FilipKosel/ODORS/End_Cap_3D_Models/End_Cap-5mm_Hole-Slotted_Edge_for_VOC_Meter.stl

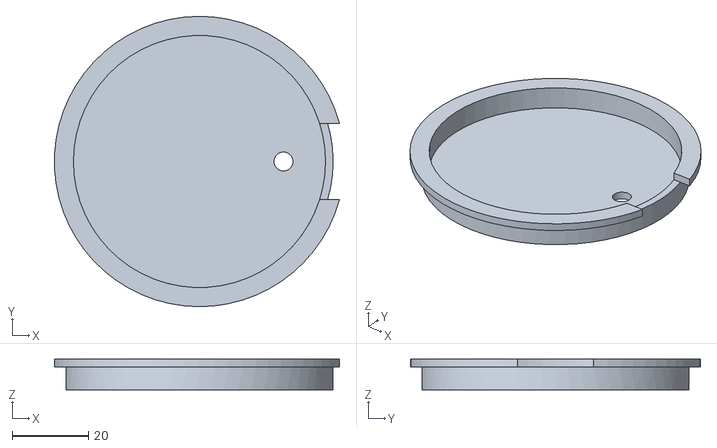
[picture p1: CAD file, 2025-01-09]
End_Cap_3D_Models/End_Cap-5mm_Hole-Slotted_Edge_for_VOC_Meter.stl
74.6 x 76.0 x 8.00
