FilipKosel/ODORS/End_Cap_3D_Models/End_Cap-Short_Odour_Tube-Solid_Edge_w_Centering_Tab-Low_Offset.stl

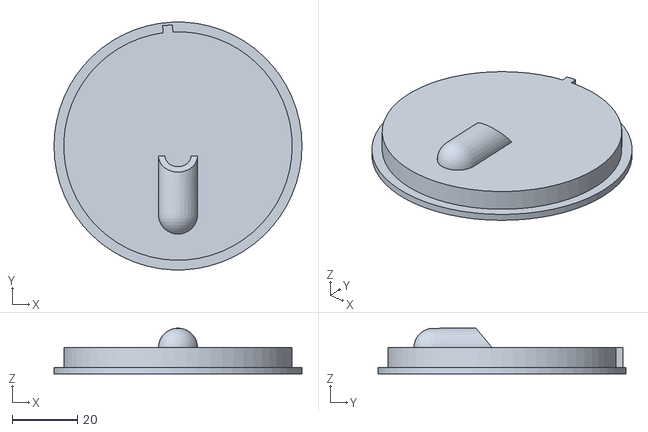
[picture p2: CAD file, 2025-01-09]
End_Cap_3D_Models/End_Cap-Short_Odour_Tube-Solid_Edge_w_Centering_Tab-Low_Offset.stl
76.0 x 75.9 x 14.0
