FilipKosel/ODORS/End_Cap_3D_Models/End_Cap-8mm_Hole-Solid_Edge.stl

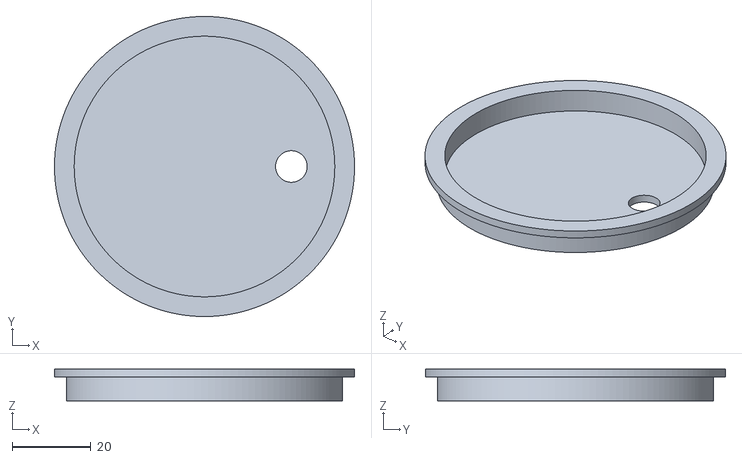
[picture p3: CAD file, 2025-01-09]
End_Cap_3D_Models/End_Cap-8mm_Hole-Solid_Edge.stl
76.0 x 76.0 x 8.00
