FilipKosel/ODORS/End_Cap_3D_Models/End_Cap-Short_Odour_Tube-Slotted_Edge_for_VOC_Meter.stl

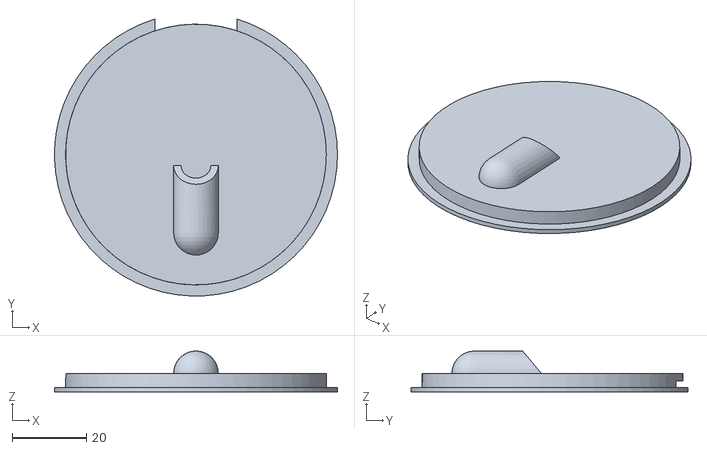
[picture p4: CAD file, 2025-01-09]
End_Cap_3D_Models/End_Cap-Short_Odour_Tube-Slotted_Edge_for_VOC_Meter.stl
76.0 x 74.3 x 11.0
