FilipKosel/ODORS/End_Cap_3D_Models/End_Cap-Long_Odour_Tube-Solid_Edge.stl

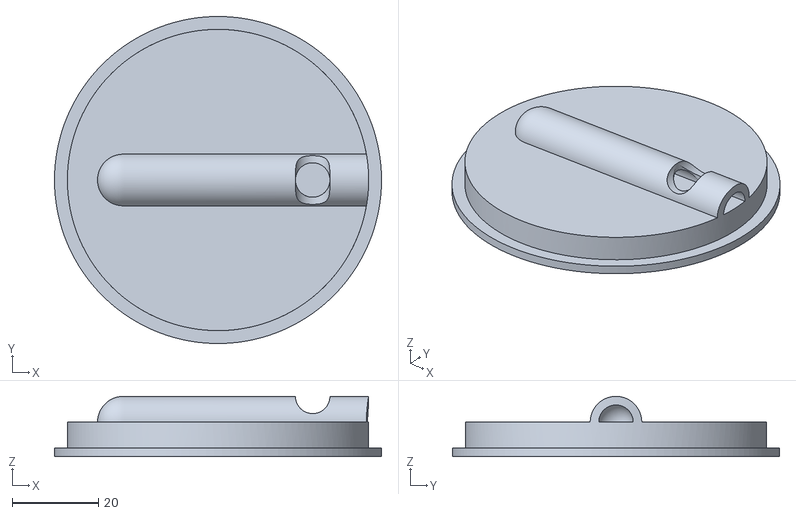
[picture p5: CAD file, 2025-01-09]
End_Cap_3D_Models/End_Cap-Long_Odour_Tube-Solid_Edge.stl
76.0 x 76.0 x 14.0
