FilipKosel/ODORS/End_Cap_3D_Models/Long_Odour_Tube-Separate_Model.stl

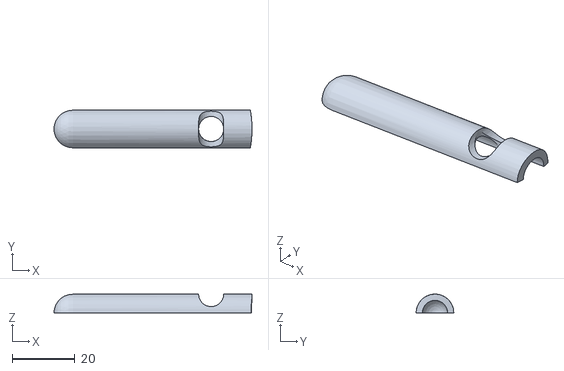
[picture p6: CAD file, 2025-01-09]
End_Cap_3D_Models/Long_Odour_Tube-Separate_Model.stl
63.0 x 12.0 x 6.00
