FilipKosel/ODORS/End_Cap_3D_Models/End_Cap-Vented-Solid_Edge_w_Centering_Tab.stl

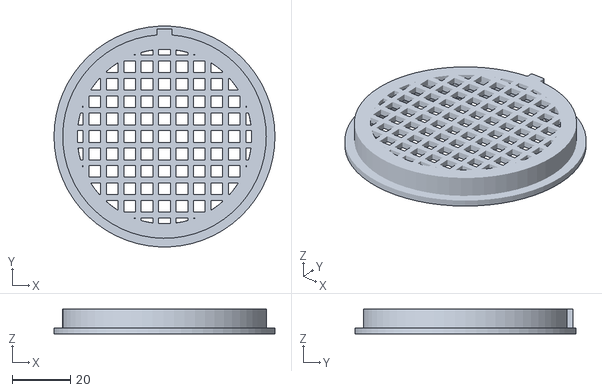
[picture p7: CAD file, 2025-01-09]
End_Cap_3D_Models/End_Cap-Vented-Solid_Edge_w_Centering_Tab.stl
76.0 x 75.9 x 8.50
