FilipKosel/ODORS/End_Cap_3D_Models/End_Cap-Short_Odour_Tube-Slotted_Edge_for_VOC_Meter_w_Centering_Tab-Centered.stl

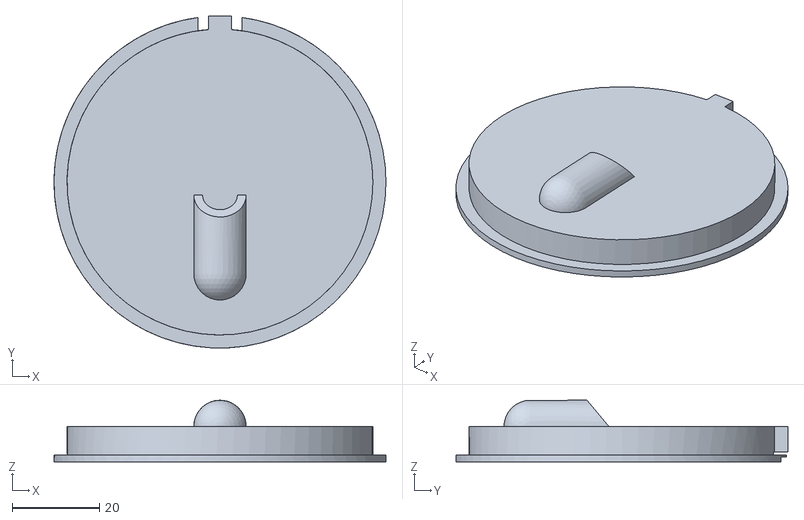
[picture p8: CAD file, 2025-01-09]
End_Cap_3D_Models/End_Cap-Short_Odour_Tube-Slotted_Edge_for_VOC_Meter_w_Centering_Tab-Centered.stl
76.0 x 76.0 x 14.1
