FilipKosel/ODORS/(list of files, cad)

Other CAD files:
End_Cap_3D_Models/End_Cap-Solid-Slotted_for_VOC_Meter.stl
End_Cap_3D_Models/End_Cap-8mm_Hole-Slotted_Edge_for_VOC_Meter.stl
End_Cap_3D_Models/End_Cap-8mm_Hole_Offset-Slotted_Edge_for_VOC_Meter.stl
End_Cap_3D_Models/End_Cap-Short_Odour_Tube-Slotted_Edge_for_VOC_Meter_w_Centering_Tab-Offset.stl
End_Cap_3D_Models/End_Cap-Short_Odour_Tube-Solid_Edge_w_Centering_Tab-Offset.stl
